KilowattSynthesis/Braille-Display-Inductors-CAD/README.md

# Braille-Display-Inductors-CAD

Braille display POC using SMD inductors as solenoids (Type 3)

## Braille Display Type 3 - Using SMD Inductors as Solenoids

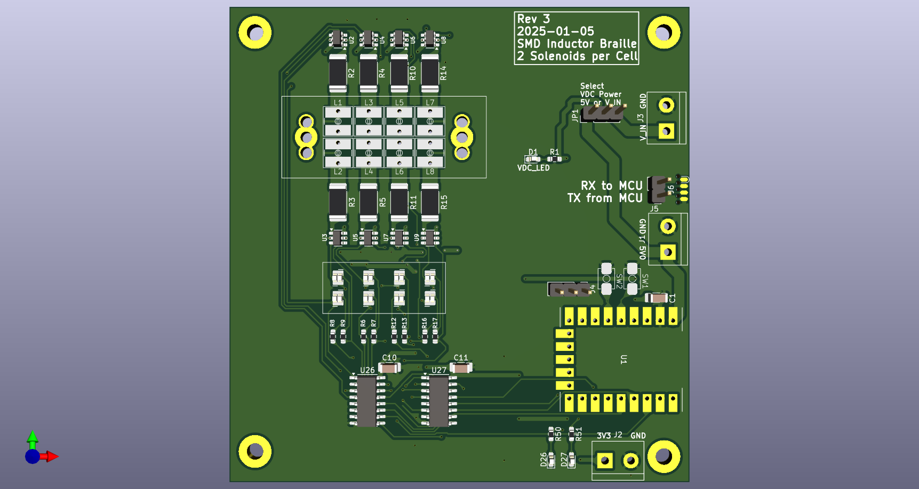
[picture p1: docs/renders/type-3-rev-3-pcb_top_render.png]
Braille Display Type 3 Rev 3 - PCB Top Render
