KilowattSynthesis/Braille-Display-Inductors-CAD/pcb/Braille-Display-with-Inductor-Solenoids/Braille-Display-with-Inductor-Solenoids.kicad_pcb

## KiCad design pcb/Braille-Display-with-Inductor-Solenoids/Braille-Display-with-Inductor-Solenoids.kicad_pcb (2025-03-18)

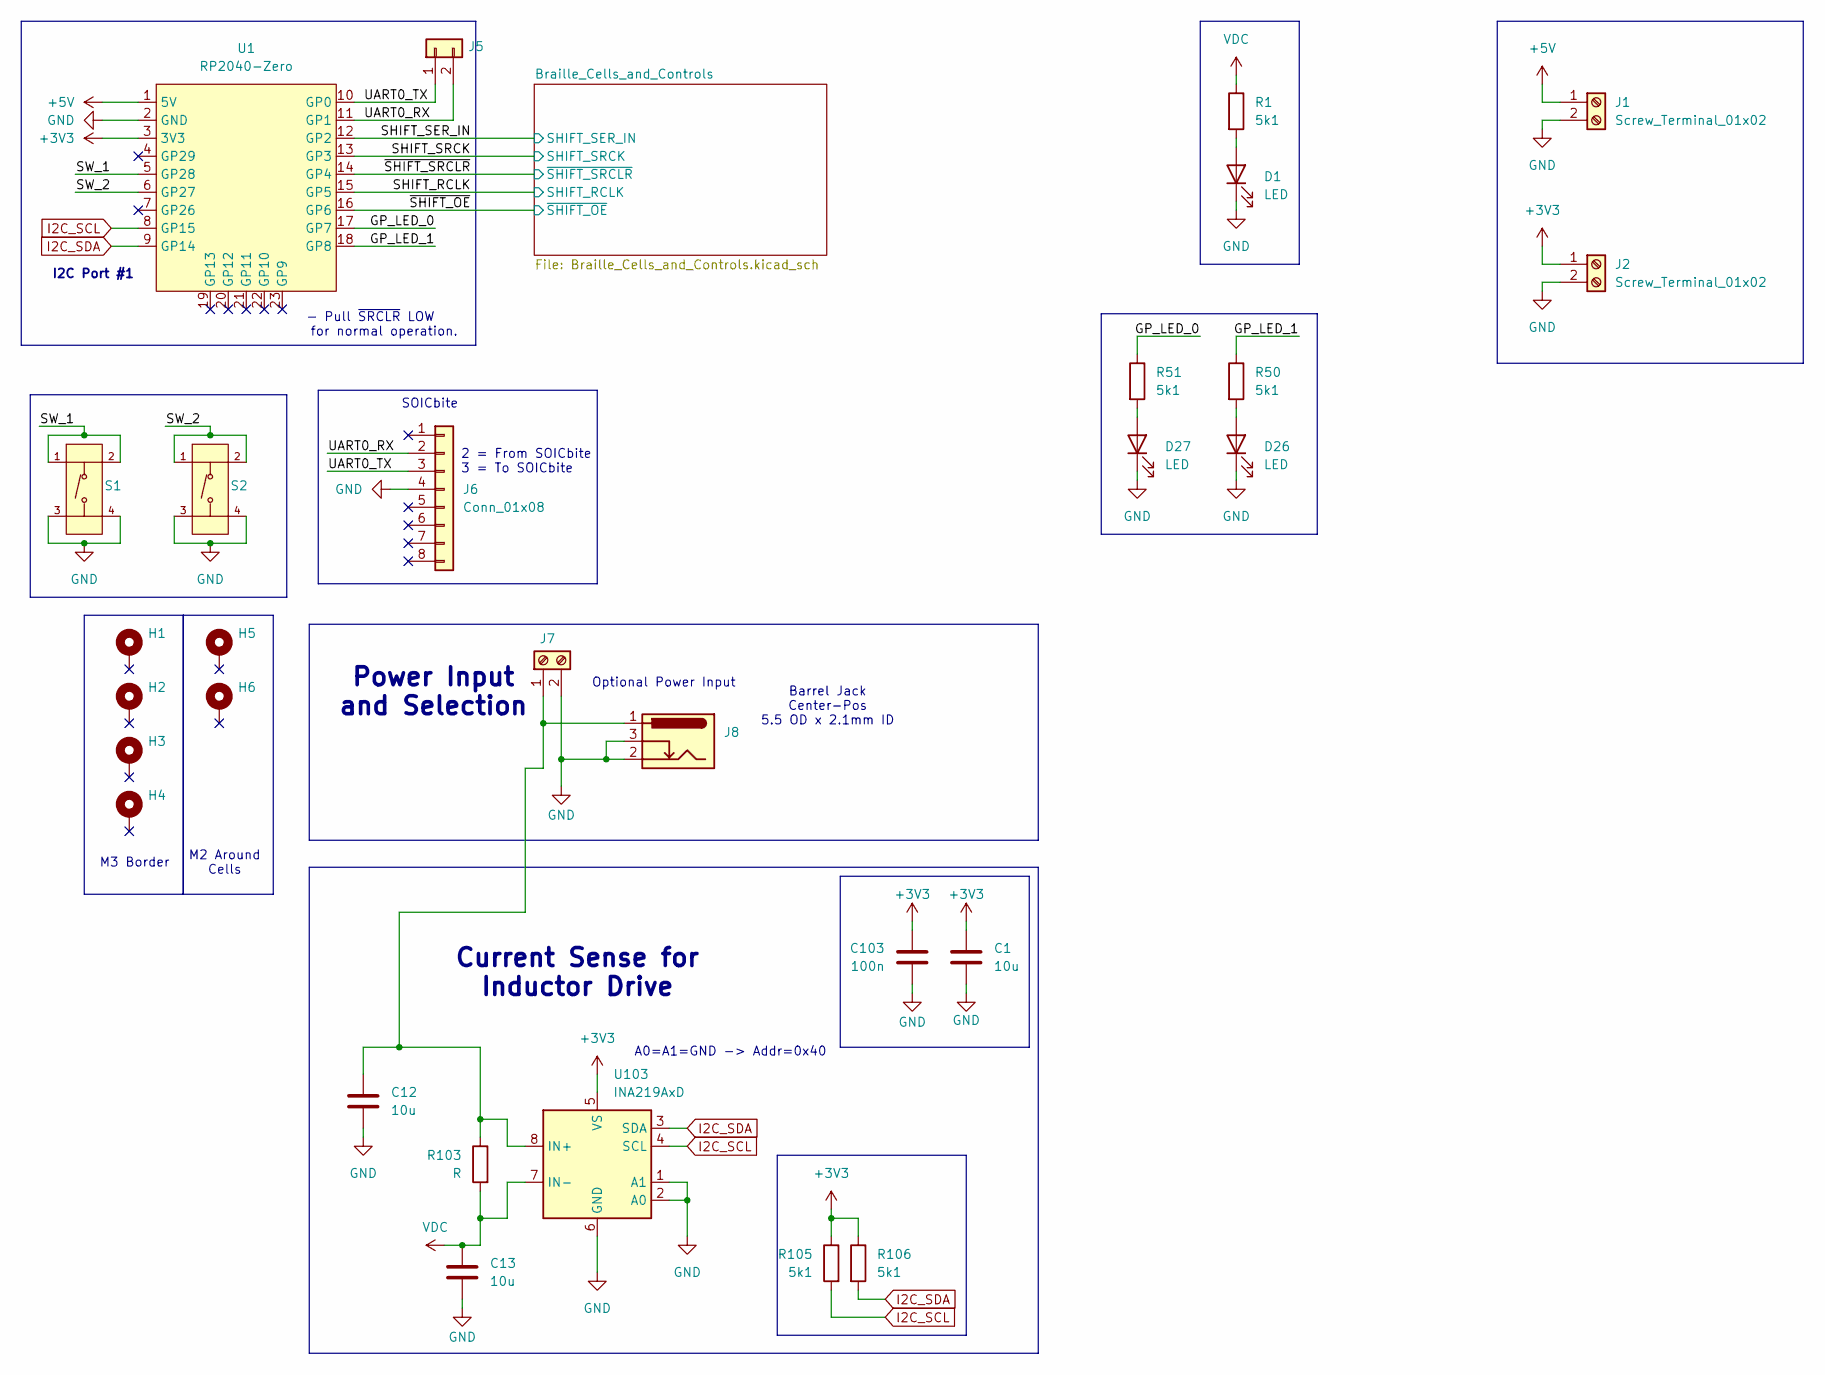
[picture p2: schematic Braille-Display-with-Inductor-Solenoids.kicad_sch]

Parts:
C1, C12, C13: 10u; C_1206_3216Metric_Pad1.33x1.80mm_HandSolder
C103: 100n; C_0603_1608Metric_Pad1.08x0.95mm_HandSolder
D1, D26, D27: LED; LED_0603_1608Metric_Pad1.05x0.95mm_HandSolder
H1, H2, H3, H4: MountingHole_Pad; MountingHole_3.2mm_M3_Pad
H5, H6: MountingHole_Pad; Braille_Block_MountingHoles_M2_3x
J1, J2, J7: Screw_Terminal_01x02; TerminalBlock_bornier-2_P5.08mm
J5: Conn_01x02; PinHeader_1x02_P2.54mm_Vertical
J6: Conn_01x08; SOICbite_clipProgSmall
J8: Barrel_Jack_Switch; BarrelJack_Horizontal
R1, R50, R51, R105, R106: 5k1; R_0603_1608Metric_Pad0.98x0.95mm_HandSolder
R103: R; R_1206_3216Metric_Pad1.30x1.75mm_HandSolder
S1, S2: Tactile Button, 160gf; SW-SMD_4P-L5.1-W5.1-P3.70-LS6.5-TL-2; Voltage Rating (Dc) 12V; Part TS-1187A-B-A-B; LCSC C318884
U1: RP2040-Zero; RP2040 Zero
U103: INA219AxD; SOIC-8_3.9x4.9mm_P1.27mm

Connections:
+3V3: C1.1, C103.1, J2.1, R105.1, R106.1, U1.3 (3V3), U103.5 (VS); also elsewhere on the board
+5V: J1.1, U1.1 (5V)
/GP_LED_0: R51.1, U1.17 (GP7)
/GP_LED_1: R50.1, U1.18 (GP8)
/SHIFT_RCLK: U1.15 (GP5); also elsewhere on the board
/SHIFT_SER_IN: U1.12 (GP2); also elsewhere on the board
/SHIFT_SRCK: U1.13 (GP3); also elsewhere on the board
/SW_1: S1.1 (A), S1.2 (B), U1.5 (GP28)
/SW_2: S2.1 (A), S2.2 (B), U1.6 (GP27)
/UART0_RX: J5.2, J6.2, U1.11 (GP1)
/UART0_TX: J5.1, J6.3, U1.10 (GP0)
/~SHIFT_OE: U1.16 (GP6); also elsewhere on the board
/~SHIFT_SRCLR: U1.14 (GP4); also elsewhere on the board
GND: C1.2, C12.2, C13.2, C103.2, D1.1 (K), D26.1 (K), D27.1 (K), J1.2, J2.2, J6.4, J7.2, J8.2, J8.3, S1.3 (C), S1.4 (D), S2.3 (C), S2.4 (D), U1.2 (GND), U103.1 (A1), U103.2 (A0), U103.6 (GND); also elsewhere on the board
I2C_SCL: R105.2, U1.8 (GP15), U103.4 (SCL)
I2C_SDA: R106.2, U1.9 (GP14), U103.3 (SDA)
unnamed: D1.2 (A), R1.2
unnamed: D26.2 (A), R50.2
unnamed: D27.2 (A), R51.2
unnamed: C12.1, J7.1, J8.1, R103.1, U103.8 (IN+)
VDC: C13.1, R1.1, R103.2, U103.7 (IN-); also elsewhere on the board

Notes on the sheet:
Barrel Jack Center-Pos 5.5 OD x 2.1mm ID
I2C Port #1
SOICbite
2 = From SOICbite 3 = To SOICbite
Optional Power Input
M2 Around Cells
- Pull ~{SRCLR} LOW for normal operation.
M3 Border
A0=A1=GND -> Addr=0x40
Power Input and Selection
Current Sense for Inductor Drive

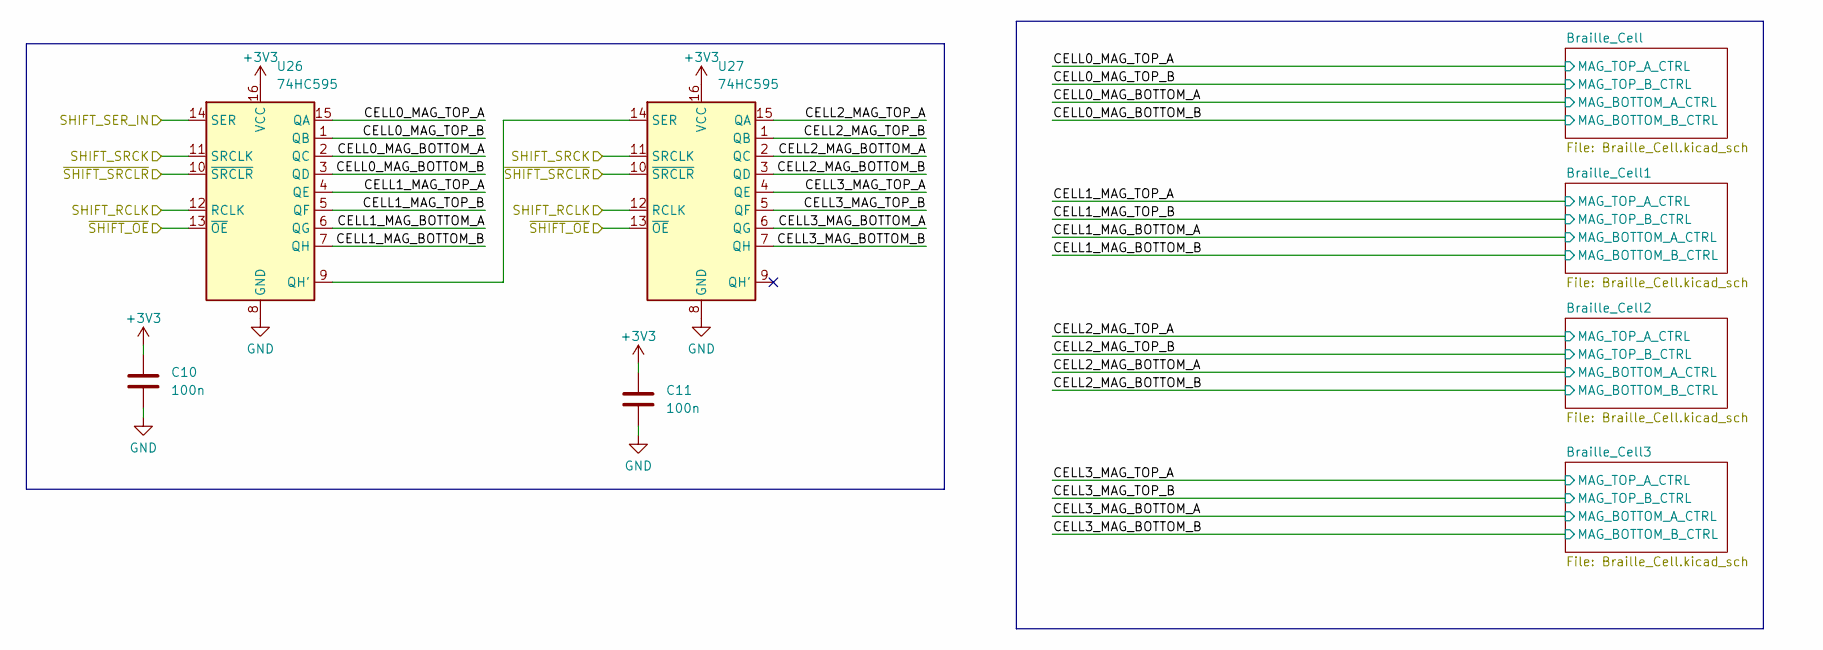
[picture p3: schematic Braille_Cells_and_Controls.kicad_sch]

Parts:
C10, C11: 100n; C_0603_1608Metric_Pad1.08x0.95mm_HandSolder
U26, U27: 74HC595; SOP-16_3.9x9.9mm_P1.27mm

Connections:
+3V3: C10.1, C11.1, U26.16 (VCC), U27.16 (VCC); also elsewhere on the board
/Braille_Cells_and_Controls/CELL0_MAG_BOTTOM_A: U26.2 (QC); also elsewhere on the board
/Braille_Cells_and_Controls/CELL0_MAG_BOTTOM_B: U26.3 (QD); also elsewhere on the board
/Braille_Cells_and_Controls/CELL0_MAG_TOP_A: U26.15 (QA); also elsewhere on the board
/Braille_Cells_and_Controls/CELL0_MAG_TOP_B: U26.1 (QB); also elsewhere on the board
/Braille_Cells_and_Controls/CELL1_MAG_BOTTOM_A: U26.6 (QG); also elsewhere on the board
/Braille_Cells_and_Controls/CELL1_MAG_BOTTOM_B: U26.7 (QH); also elsewhere on the board
/Braille_Cells_and_Controls/CELL1_MAG_TOP_A: U26.4 (QE); also elsewhere on the board
/Braille_Cells_and_Controls/CELL1_MAG_TOP_B: U26.5 (QF); also elsewhere on the board
/Braille_Cells_and_Controls/CELL2_MAG_BOTTOM_A: U27.2 (QC); also elsewhere on the board
/Braille_Cells_and_Controls/CELL2_MAG_BOTTOM_B: U27.3 (QD); also elsewhere on the board
/Braille_Cells_and_Controls/CELL2_MAG_TOP_A: U27.15 (QA); also elsewhere on the board
/Braille_Cells_and_Controls/CELL2_MAG_TOP_B: U27.1 (QB); also elsewhere on the board
/Braille_Cells_and_Controls/CELL3_MAG_BOTTOM_A: U27.6 (QG); also elsewhere on the board
/Braille_Cells_and_Controls/CELL3_MAG_BOTTOM_B: U27.7 (QH); also elsewhere on the board
/Braille_Cells_and_Controls/CELL3_MAG_TOP_A: U27.4 (QE); also elsewhere on the board
/Braille_Cells_and_Controls/CELL3_MAG_TOP_B: U27.5 (QF); also elsewhere on the board
/SHIFT_RCLK: U26.12 (RCLK), U27.12 (RCLK); also elsewhere on the board
/SHIFT_SER_IN: U26.14 (SER); also elsewhere on the board
/SHIFT_SRCK: U26.11 (SRCLK), U27.11 (SRCLK); also elsewhere on the board
/~SHIFT_OE: U26.13 (~OE), U27.13 (~OE); also elsewhere on the board
/~SHIFT_SRCLR: U26.10 (~SRCLR), U27.10 (~SRCLR); also elsewhere on the board
GND: C10.2, C11.2, U26.8 (GND), U27.8 (GND); also elsewhere on the board
unnamed: U26.9 (QH'), U27.14 (SER)

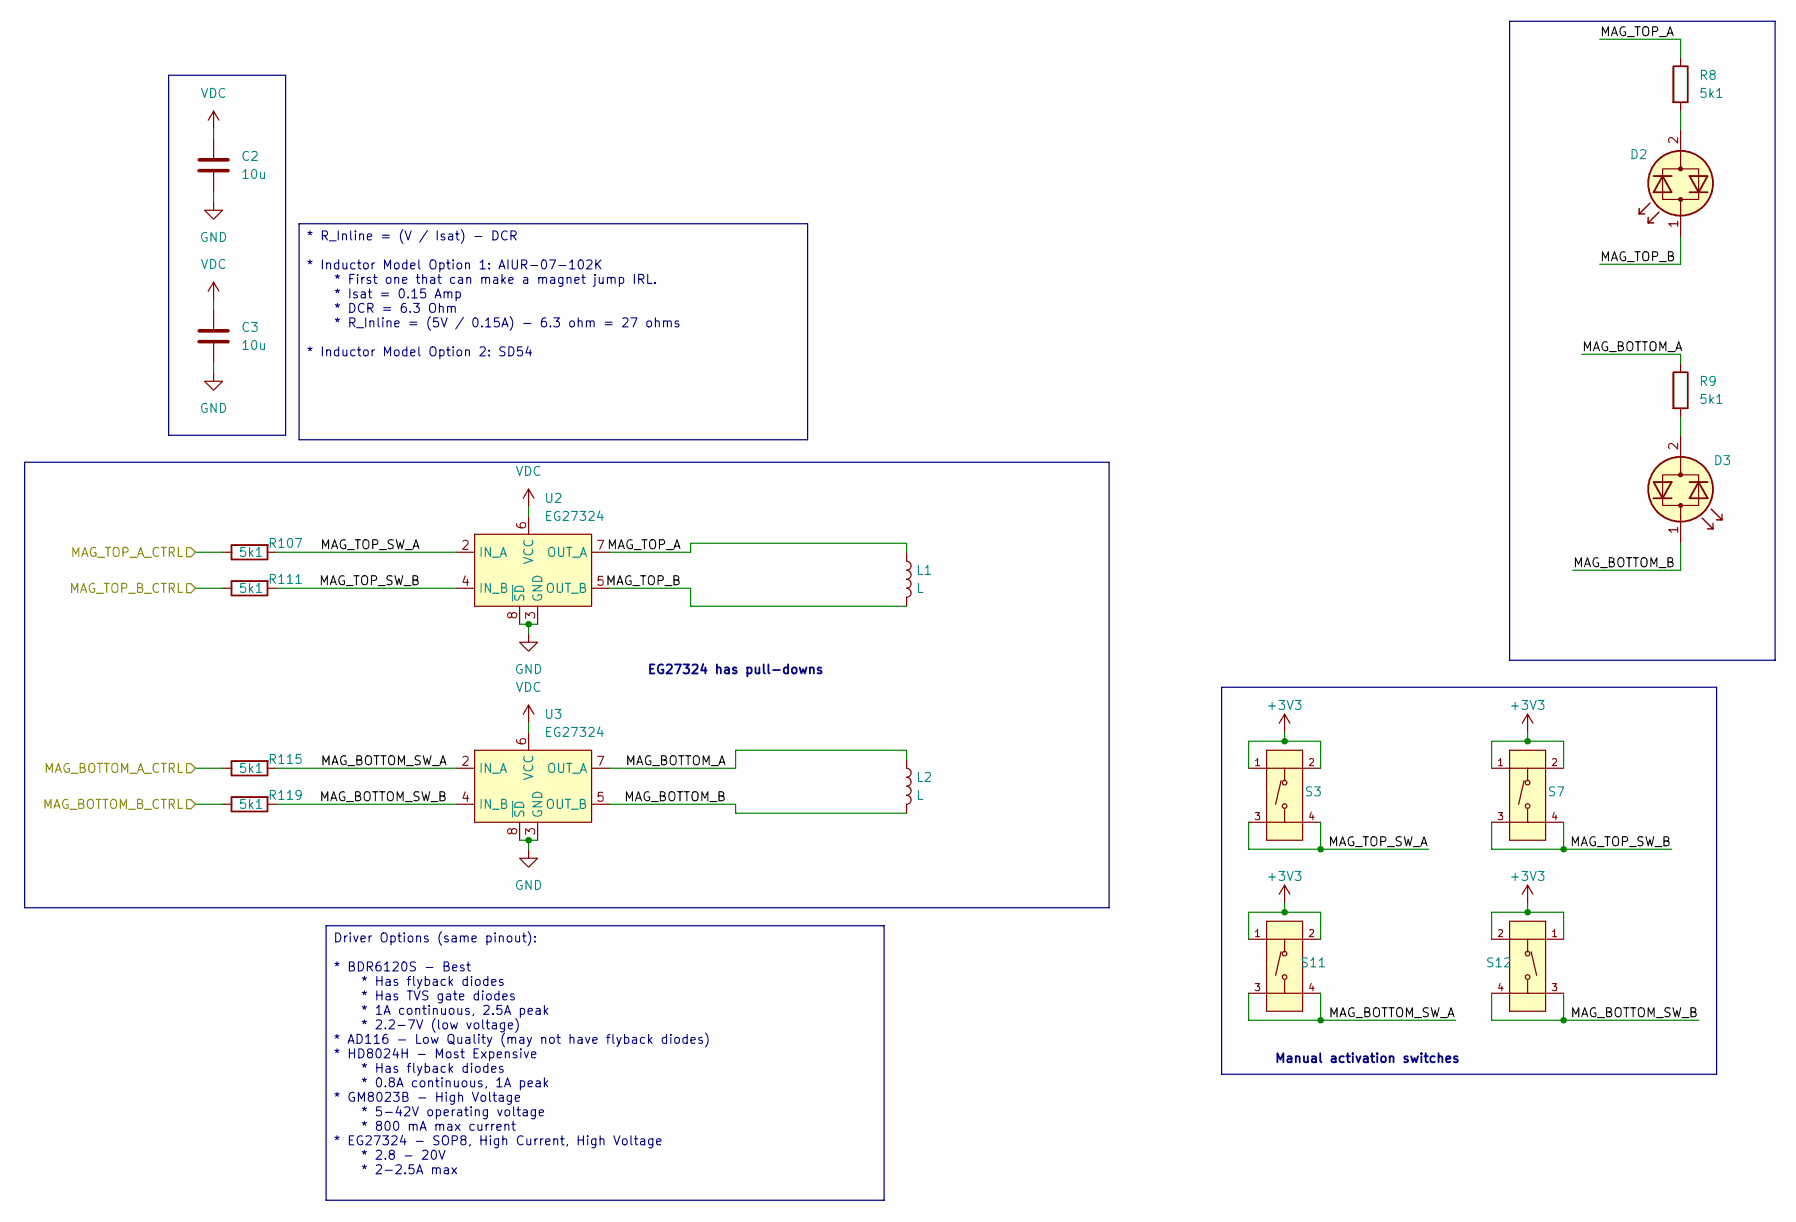
[picture p4: schematic Braille_Cell.kicad_sch]

Parts:
C2, C3: 10u; C_1206_3216Metric_Pad1.33x1.80mm_HandSolder
D2, D3: LED_Dual_Bidirectional; LED_0603_1608Metric_HandSolder_2x_Reverse
L1, L2: L; Inductor_6mm_AIUR-07-102K_THT_SD54_SMD
R8, R9, R107, R111, R115, R119: 5k1; R_0603_1608Metric_Pad0.98x0.95mm_HandSolder
S3, S7, S11, S12: Tactile Button, 160gf; SW-SMD_4P-L5.1-W5.1-P3.70-LS6.5-TL-2; Voltage Rating (Dc) 12V; Part TS-1187A-B-A-B; LCSC C318884
U2, U3: EG27324; SOP-8_3.9x4.9mm_P1.27mm

Connections:
+3V3: S3.1 (A), S3.2 (B), S7.1 (A), S7.2 (B), S11.1 (A), S11.2 (B), S12.1 (A), S12.2 (B); also elsewhere on the board
/Braille_Cells_and_Controls/Braille_Cell/MAG_BOTTOM_A: L2.1, R9.1, U3.7 (OUT_A)
/Braille_Cells_and_Controls/Braille_Cell/MAG_BOTTOM_B: D3.1 (KA), L2.2, U3.5 (OUT_B)
/Braille_Cells_and_Controls/Braille_Cell/MAG_BOTTOM_SW_A: R115.2, S11.3 (C), S11.4 (D), U3.2 (IN_A)
/Braille_Cells_and_Controls/Braille_Cell/MAG_BOTTOM_SW_B: R119.2, S12.3 (C), S12.4 (D), U3.4 (IN_B)
/Braille_Cells_and_Controls/Braille_Cell/MAG_TOP_A: L1.1, R8.1, U2.7 (OUT_A)
/Braille_Cells_and_Controls/Braille_Cell/MAG_TOP_B: D2.1 (KA), L1.2, U2.5 (OUT_B)
/Braille_Cells_and_Controls/Braille_Cell/MAG_TOP_SW_A: R107.2, S3.3 (C), S3.4 (D), U2.2 (IN_A)
/Braille_Cells_and_Controls/Braille_Cell/MAG_TOP_SW_B: R111.2, S7.3 (C), S7.4 (D), U2.4 (IN_B)
/Braille_Cells_and_Controls/CELL0_MAG_BOTTOM_A: R115.1; also elsewhere on the board
/Braille_Cells_and_Controls/CELL0_MAG_BOTTOM_B: R119.1; also elsewhere on the board
/Braille_Cells_and_Controls/CELL0_MAG_TOP_A: R107.1; also elsewhere on the board
/Braille_Cells_and_Controls/CELL0_MAG_TOP_B: R111.1; also elsewhere on the board
GND: C2.2, C3.2, U2.3 (GND), U2.8 (~SD), U3.3 (GND), U3.8 (~SD); also elsewhere on the board
unnamed: D2.2 (AK), R8.2
unnamed: D3.2 (AK), R9.2
VDC: C2.1, C3.1, U2.6 (VCC), U3.6 (VCC); also elsewhere on the board

Parts of its further copies:
C4, C5, C6, C7, C8, C9: 10u; C_1206_3216Metric_Pad1.33x1.80mm_HandSolder
D4, D5, D6, D7, D8, D9: LED_Dual_Bidirectional; LED_0603_1608Metric_HandSolder_2x_Reverse
L3, L4, L5, L6, L7, L8: L; Inductor_6mm_AIUR-07-102K_THT_SD54_SMD
R6, R7, R12, R13, R16, R17, R108, R109, R110, R112, R113, R114, R116, R117, R118, R120, R121, R122: 5k1; R_0603_1608Metric_Pad0.98x0.95mm_HandSolder
S4, S5, S6, S8, S9, S10, S13, S14, S15, S16, S17, S18: Tactile Button, 160gf; SW-SMD_4P-L5.1-W5.1-P3.70-LS6.5-TL-2; Voltage Rating (Dc) 12V; Part TS-1187A-B-A-B; LCSC C318884
U4, U5, U6, U7, U8, U9: EG27324; SOP-8_3.9x4.9mm_P1.27mm

Connections of its further copies:
+3V3: S4.1 (A), S4.2 (B), S5.1 (A), S5.2 (B), S6.1 (A), S6.2 (B), S8.1 (A), S8.2 (B), S9.1 (A), S9.2 (B), S10.1 (A), S10.2 (B), S13.1 (A), S13.2 (B), S14.1 (A), S14.2 (B), S15.1 (A), S15.2 (B), S16.1 (A), S16.2 (B), S17.1 (A), S17.2 (B), S18.1 (A), S18.2 (B); also elsewhere on the board
/Braille_Cells_and_Controls/Braille_Cell1/MAG_BOTTOM_A: L4.1, R7.1, U5.7 (OUT_A)
/Braille_Cells_and_Controls/Braille_Cell1/MAG_BOTTOM_B: D5.1 (KA), L4.2, U5.5 (OUT_B)
/Braille_Cells_and_Controls/Braille_Cell1/MAG_BOTTOM_SW_A: R116.2, S13.3 (C), S13.4 (D), U5.2 (IN_A)
/Braille_Cells_and_Controls/Braille_Cell1/MAG_BOTTOM_SW_B: R120.2, S14.3 (C), S14.4 (D), U5.4 (IN_B)
/Braille_Cells_and_Controls/Braille_Cell1/MAG_TOP_A: L3.1, R6.1, U4.7 (OUT_A)
/Braille_Cells_and_Controls/Braille_Cell1/MAG_TOP_B: D4.1 (KA), L3.2, U4.5 (OUT_B)
/Braille_Cells_and_Controls/Braille_Cell1/MAG_TOP_SW_A: R108.2, S4.3 (C), S4.4 (D), U4.2 (IN_A)
/Braille_Cells_and_Controls/Braille_Cell1/MAG_TOP_SW_B: R112.2, S8.3 (C), S8.4 (D), U4.4 (IN_B)
/Braille_Cells_and_Controls/Braille_Cell2/MAG_BOTTOM_A: L6.1, R13.1, U7.7 (OUT_A)
/Braille_Cells_and_Controls/Braille_Cell2/MAG_BOTTOM_B: D7.1 (KA), L6.2, U7.5 (OUT_B)
/Braille_Cells_and_Controls/Braille_Cell2/MAG_BOTTOM_SW_A: R117.2, S15.3 (C), S15.4 (D), U7.2 (IN_A)
/Braille_Cells_and_Controls/Braille_Cell2/MAG_BOTTOM_SW_B: R121.2, S16.3 (C), S16.4 (D), U7.4 (IN_B)
/Braille_Cells_and_Controls/Braille_Cell2/MAG_TOP_A: L5.1, R12.1, U6.7 (OUT_A)
/Braille_Cells_and_Controls/Braille_Cell2/MAG_TOP_B: D6.1 (KA), L5.2, U6.5 (OUT_B)
/Braille_Cells_and_Controls/Braille_Cell2/MAG_TOP_SW_A: R109.2, S5.3 (C), S5.4 (D), U6.2 (IN_A)
/Braille_Cells_and_Controls/Braille_Cell2/MAG_TOP_SW_B: R113.2, S9.3 (C), S9.4 (D), U6.4 (IN_B)
/Braille_Cells_and_Controls/Braille_Cell3/MAG_BOTTOM_A: L8.1, R17.1, U9.7 (OUT_A)
/Braille_Cells_and_Controls/Braille_Cell3/MAG_BOTTOM_B: D9.1 (KA), L8.2, U9.5 (OUT_B)
/Braille_Cells_and_Controls/Braille_Cell3/MAG_BOTTOM_SW_A: R118.2, S17.3 (C), S17.4 (D), U9.2 (IN_A)
/Braille_Cells_and_Controls/Braille_Cell3/MAG_BOTTOM_SW_B: R122.2, S18.3 (C), S18.4 (D), U9.4 (IN_B)
/Braille_Cells_and_Controls/Braille_Cell3/MAG_TOP_A: L7.1, R16.1, U8.7 (OUT_A)
/Braille_Cells_and_Controls/Braille_Cell3/MAG_TOP_B: D8.1 (KA), L7.2, U8.5 (OUT_B)
/Braille_Cells_and_Controls/Braille_Cell3/MAG_TOP_SW_A: R110.2, S6.3 (C), S6.4 (D), U8.2 (IN_A)
/Braille_Cells_and_Controls/Braille_Cell3/MAG_TOP_SW_B: R114.2, S10.3 (C), S10.4 (D), U8.4 (IN_B)
/Braille_Cells_and_Controls/CELL1_MAG_BOTTOM_A: R116.1; also elsewhere on the board
/Braille_Cells_and_Controls/CELL1_MAG_BOTTOM_B: R120.1; also elsewhere on the board
/Braille_Cells_and_Controls/CELL1_MAG_TOP_A: R108.1; also elsewhere on the board
/Braille_Cells_and_Controls/CELL1_MAG_TOP_B: R112.1; also elsewhere on the board
/Braille_Cells_and_Controls/CELL2_MAG_BOTTOM_A: R117.1; also elsewhere on the board
/Braille_Cells_and_Controls/CELL2_MAG_BOTTOM_B: R121.1; also elsewhere on the board
/Braille_Cells_and_Controls/CELL2_MAG_TOP_A: R109.1; also elsewhere on the board
/Braille_Cells_and_Controls/CELL2_MAG_TOP_B: R113.1; also elsewhere on the board
/Braille_Cells_and_Controls/CELL3_MAG_BOTTOM_A: R118.1; also elsewhere on the board
/Braille_Cells_and_Controls/CELL3_MAG_BOTTOM_B: R122.1; also elsewhere on the board
/Braille_Cells_and_Controls/CELL3_MAG_TOP_A: R110.1; also elsewhere on the board
/Braille_Cells_and_Controls/CELL3_MAG_TOP_B: R114.1; also elsewhere on the board
GND: C4.2, C5.2, C6.2, C7.2, C8.2, C9.2, U4.3 (GND), U4.8 (~SD), U5.3 (GND), U5.8 (~SD), U6.3 (GND), U6.8 (~SD), U7.3 (GND), U7.8 (~SD), U8.3 (GND), U8.8 (~SD), U9.3 (GND), U9.8 (~SD); also elsewhere on the board
unnamed: D4.2 (AK), R6.2
unnamed: D5.2 (AK), R7.2
unnamed: D6.2 (AK), R12.2
unnamed: D7.2 (AK), R13.2
unnamed: D8.2 (AK), R16.2
unnamed: D9.2 (AK), R17.2
VDC: C4.1, C5.1, C6.1, C7.1, C8.1, C9.1, U4.6 (VCC), U5.6 (VCC), U6.6 (VCC), U7.6 (VCC), U8.6 (VCC), U9.6 (VCC); also elsewhere on the board

Notes on the sheet:
Manual activation switches
EG27324 has pull-downs
Driver Options (same pinout): * BDR6120S - Best * Has flyback diodes * Has TVS gate diodes * 1A continuous, 2.5A peak * 2.2-7V (low voltage) * AD116 - Low Quality (may not have flyback diodes) * HD8024H - Most Expensive * Has flyback diodes * 0.8A continuous, 1A peak * GM8023B - High Voltage * 5-42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
* R_Inline = (V / Isat) - DCR * Inductor Model Option 1: AIUR-07-102K * First one that can make a magnet jump IRL. * Isat = 0.15 Amp * DCR = 6.3 Ohm * R_Inline = (5V / 0.15A) - 6.3 ohm = 27 ohms * Inductor Model Option 2: SD54

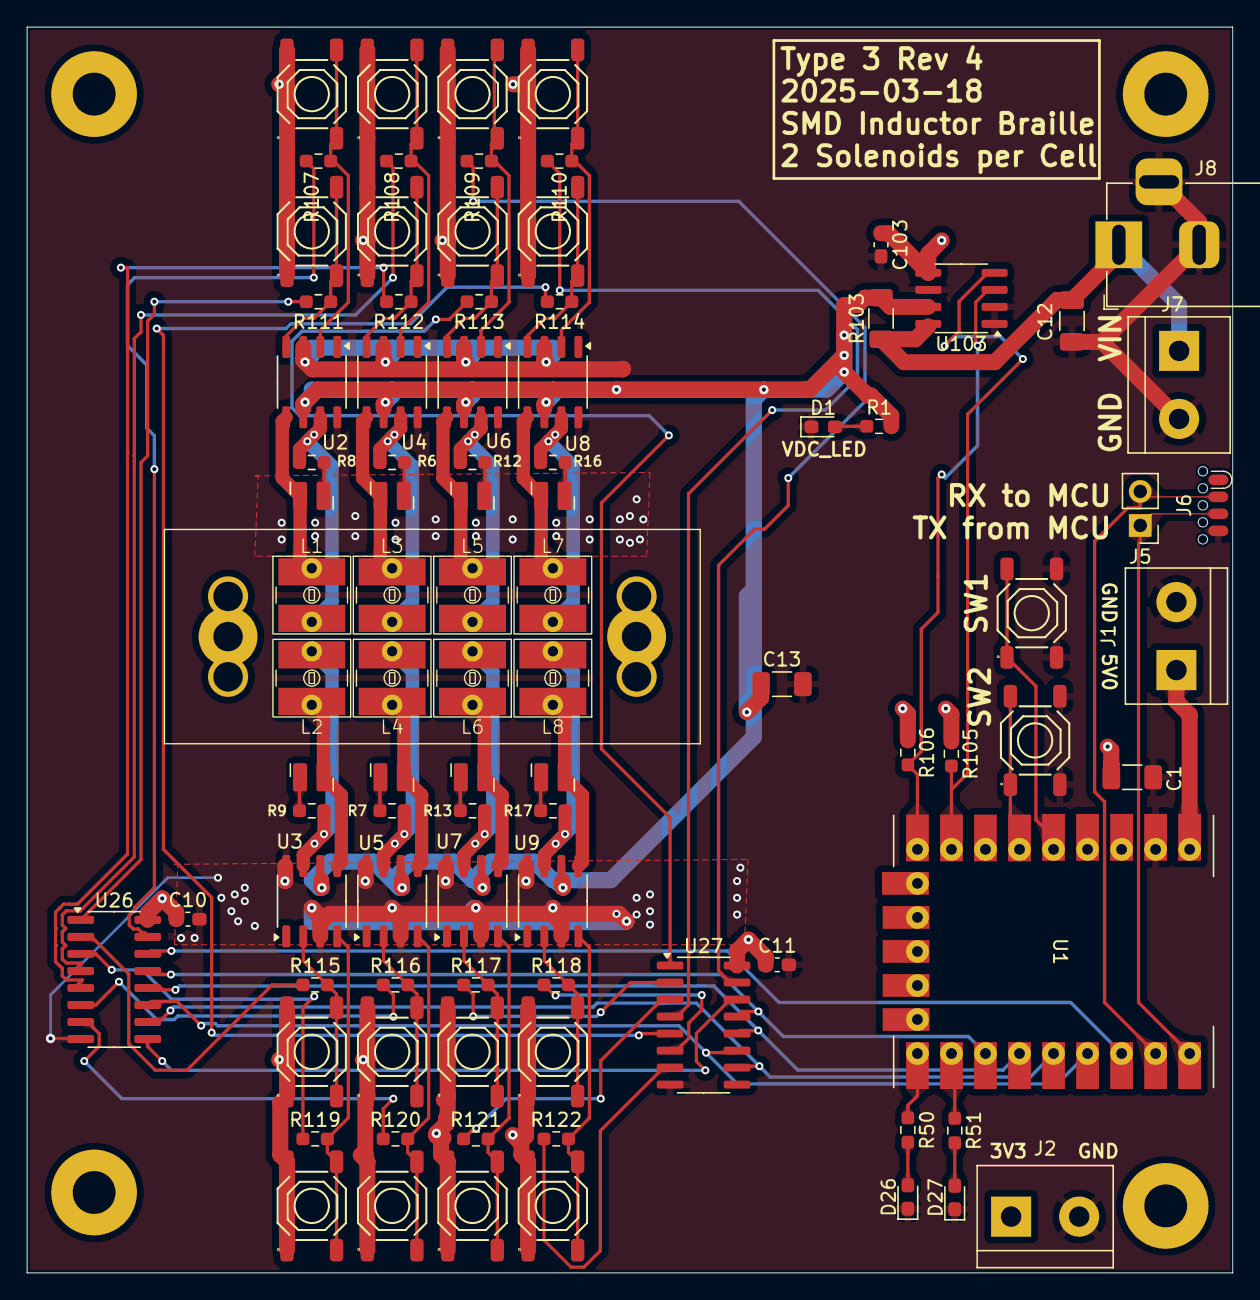
[picture p5: board Braille-Display-with-Inductor-Solenoids.kicad_pcb from above]

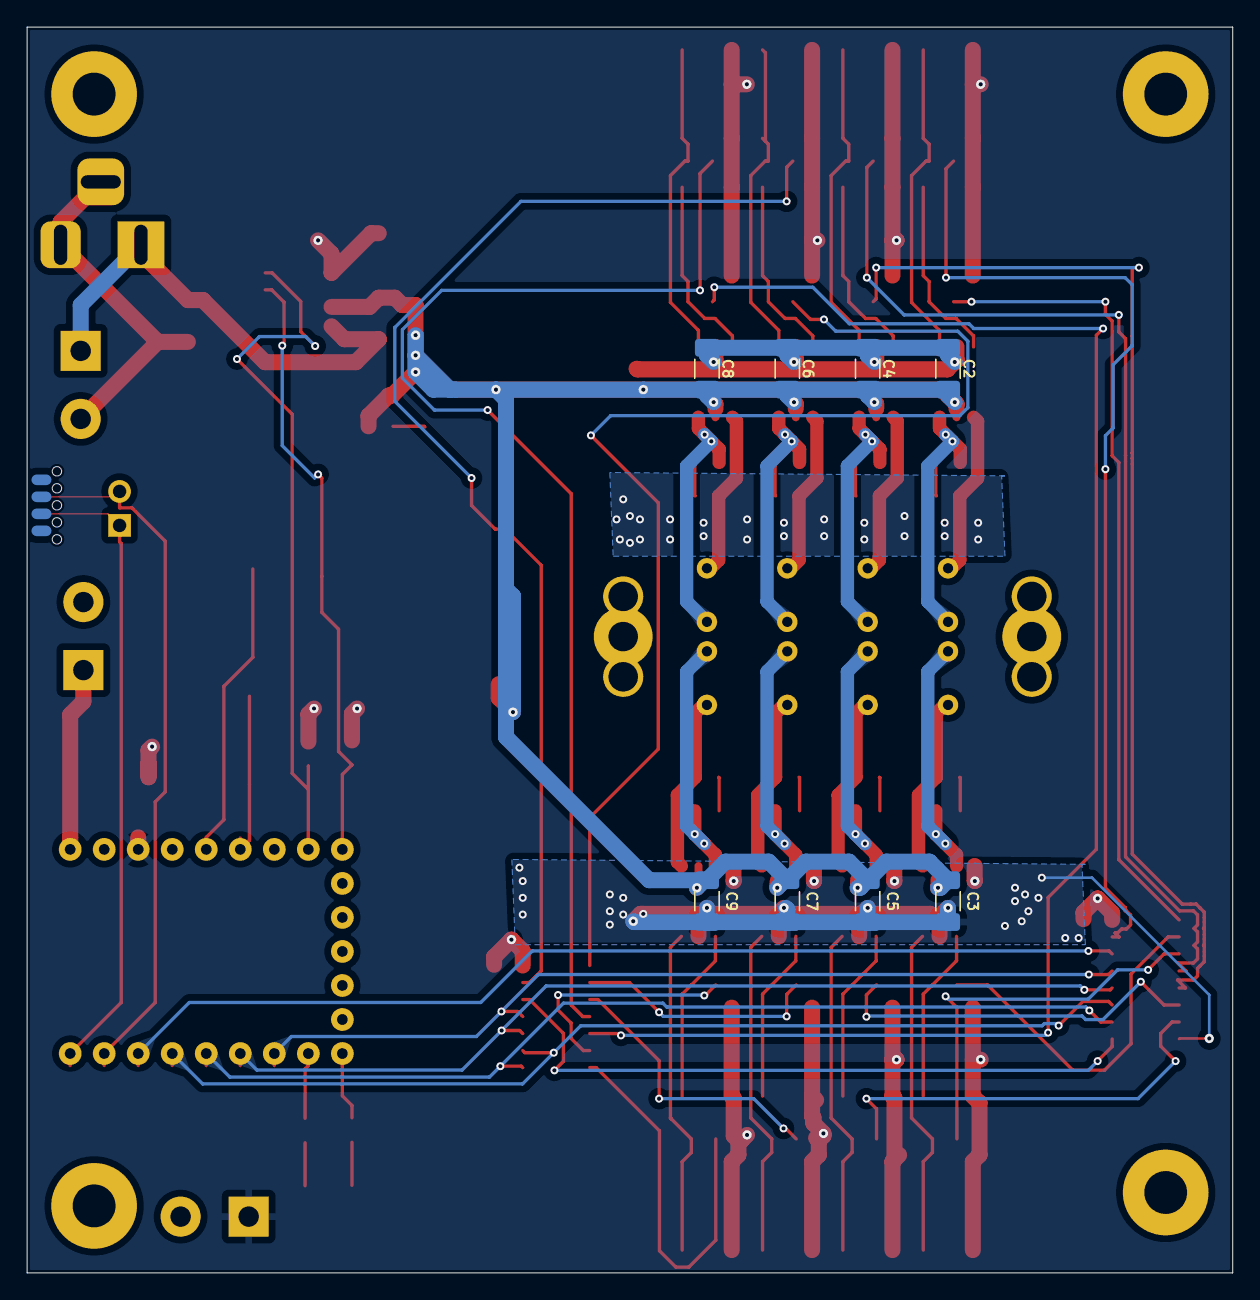
[picture p6: board Braille-Display-with-Inductor-Solenoids.kicad_pcb from below]

Board: 2 copper layers, 90.0 x 93.0 mm, 105 parts (8 on the bottom side), 78 nets.
