KilowattSynthesis/Braille-Display-Inductors-CAD/(commit log)

2024-11-17 Readd original project
    [Braille-Display-with-Inductor-Solenoids.kicad_pcb, Braille-Display-with-Inductor-Solenoids.kicad_sch, Braille_Cell.kicad_sch]
2024-11-17 Remove symbol and footprint libraries
    [Braille-Display-with-Inductor-Solenoids.kicad_pcb, Braille-Display-with-Inductor-Solenoids.kicad_sch, Braille_Cell.kicad_sch]
2024-11-17 Add top-type inductor footprint
2024-11-17 Add both inductors on same PCB, switch to new drivers
    [Braille-Display-with-Inductor-Solenoids.kicad_pcb, Braille-Display-with-Inductor-Solenoids.kicad_sch, Braille_Cell.kicad_sch]
2024-11-17 Do layout
    [Braille-Display-with-Inductor-Solenoids.kicad_pcb]
2024-11-17 Add breakouts, shrink SMD vertical inductor cutouts, add braille cell (4x now)
    [Braille-Display-with-Inductor-Solenoids.kicad_pcb, Braille-Display-with-Inductor-Solenoids.kicad_sch, Braille_Cell.kicad_sch]
2024-11-17 Change page layout and reconnect components
    [Braille-Display-with-Inductor-Solenoids.kicad_pcb, Braille-Display-with-Inductor-Solenoids.kicad_sch, Braille_Cell.kicad_sch, Braille_Cells_and_Controls.kicad_sch]
2024-11-17 Layout debugging components
    [Braille-Display-with-Inductor-Solenoids.kicad_pcb, Braille-Display-with-Inductor-Solenoids.kicad_sch, Braille_Cell.kicad_sch, Braille_Cells_and_Controls.kicad_sch]
2024-11-17 Add UART soicbite
    [Braille-Display-with-Inductor-Solenoids.kicad_pcb, Braille-Display-with-Inductor-Solenoids.kicad_sch]
2024-11-17 Layout SOICbite footprint
    [Braille-Display-with-Inductor-Solenoids.kicad_pcb, Braille-Display-with-Inductor-Solenoids.kicad_sch]
2024-11-18 Clean up reference designator silkscreens, add layers
    [Braille-Display-with-Inductor-Solenoids.kicad_pcb]
2024-11-18 Fix braille LED swap
    [Braille-Display-with-Inductor-Solenoids.kicad_pcb]
2024-11-18 Finish routing and review
    [Braille-Display-with-Inductor-Solenoids.kicad_pcb]
2024-11-27 Update SMD solenoid with THT pads
    [Braille-Display-with-Inductor-Solenoids.kicad_pcb, Braille_Cell.kicad_sch]
2024-11-27 Add holes to SMD inductors, prepare for Rev 2
    [Braille-Display-with-Inductor-Solenoids.kicad_sch, Braille_Cell.kicad_sch, Braille_Cells_and_Controls.kicad_sch]
2025-01-03 Add Rev 2 FIXMEs
    [Braille_Cell.kicad_sch]
2025-01-03 Setup build123d CAD project
2025-01-03 Start designing bottom housing, create CAD plan
2025-01-03 Add dot model and assembly
2025-01-03 Create the top-side housing
2025-01-03 Create printable 3d stencil
2025-01-03 Add solenoid protrusions, optimize bottom housing thickness
2025-01-03 PCB: Create Locking Stencil single instance
    [Locking-Stencil-PCB.kicad_pcb, Locking-Stencil-PCB.kicad_sch]
2025-01-03 Create stencil order
    [Locking-Stencil-PCB.kicad_pcb]
2025-01-06 PCB (Rev 3): Switch to 2 inductors per cell (#2)
    * WIP (Rev3): Switch to 2 inductors per cell
    * WIP: Route one cell
    * WIP: Route more of the board
    * WIP: Swap around power input placement
    * Finish and polish design
    * Bit of tiny routing, export production file
    [Braille-Display-with-Inductor-Solenoids.kicad_sch, Braille_Cell.kicad_sch, Braille_Cells_and_Controls.kicad_sch]
2025-01-06 Refactor CAD generation to support `dot_count_y=4`
2025-01-06 CAD: Simplify solenoid block removal, add dot drainage holes
2025-01-10 Update firmware with button response actions (for rev-2 board)
2025-03-13 pcb: Migrate to KiCAD v9
    [Braille-Display-with-Inductor-Solenoids.kicad_pcb, Braille-Display-with-Inductor-Solenoids.kicad_sch, Braille_Cell.kicad_sch, Braille_Cells_and_Controls.kicad_sch]
2025-03-18 pcb: WIP - Switch to new parts, layout
    [Braille-Display-with-Inductor-Solenoids.kicad_pcb, Braille-Display-with-Inductor-Solenoids.kicad_sch, Braille_Cell.kicad_sch, Braille_Cells_and_Controls.kicad_sch]
2025-03-18 pcb: WIP - High power and repeated routing
    [Braille-Display-with-Inductor-Solenoids.kicad_pcb, Braille-Display-with-Inductor-Solenoids.kicad_sch, Braille_Cell.kicad_sch]
2025-03-18 Finish Rev 4
    [Braille-Display-with-Inductor-Solenoids.kicad_pcb]
2025-03-18 Bump version numbers
    [Braille-Display-with-Inductor-Solenoids.kicad_pcb, Braille-Display-with-Inductor-Solenoids.kicad_sch, Braille_Cell.kicad_sch, Braille_Cells_and_Controls.kicad_sch]
